greyltc/mechanical/squirrel/notes.txt

needs verification:
1) substarte slot size to remain unchanged from previous versions: 25.354 square
