greyltc/mechanical/chamber_ng/drawings/chamber_plan.dxf

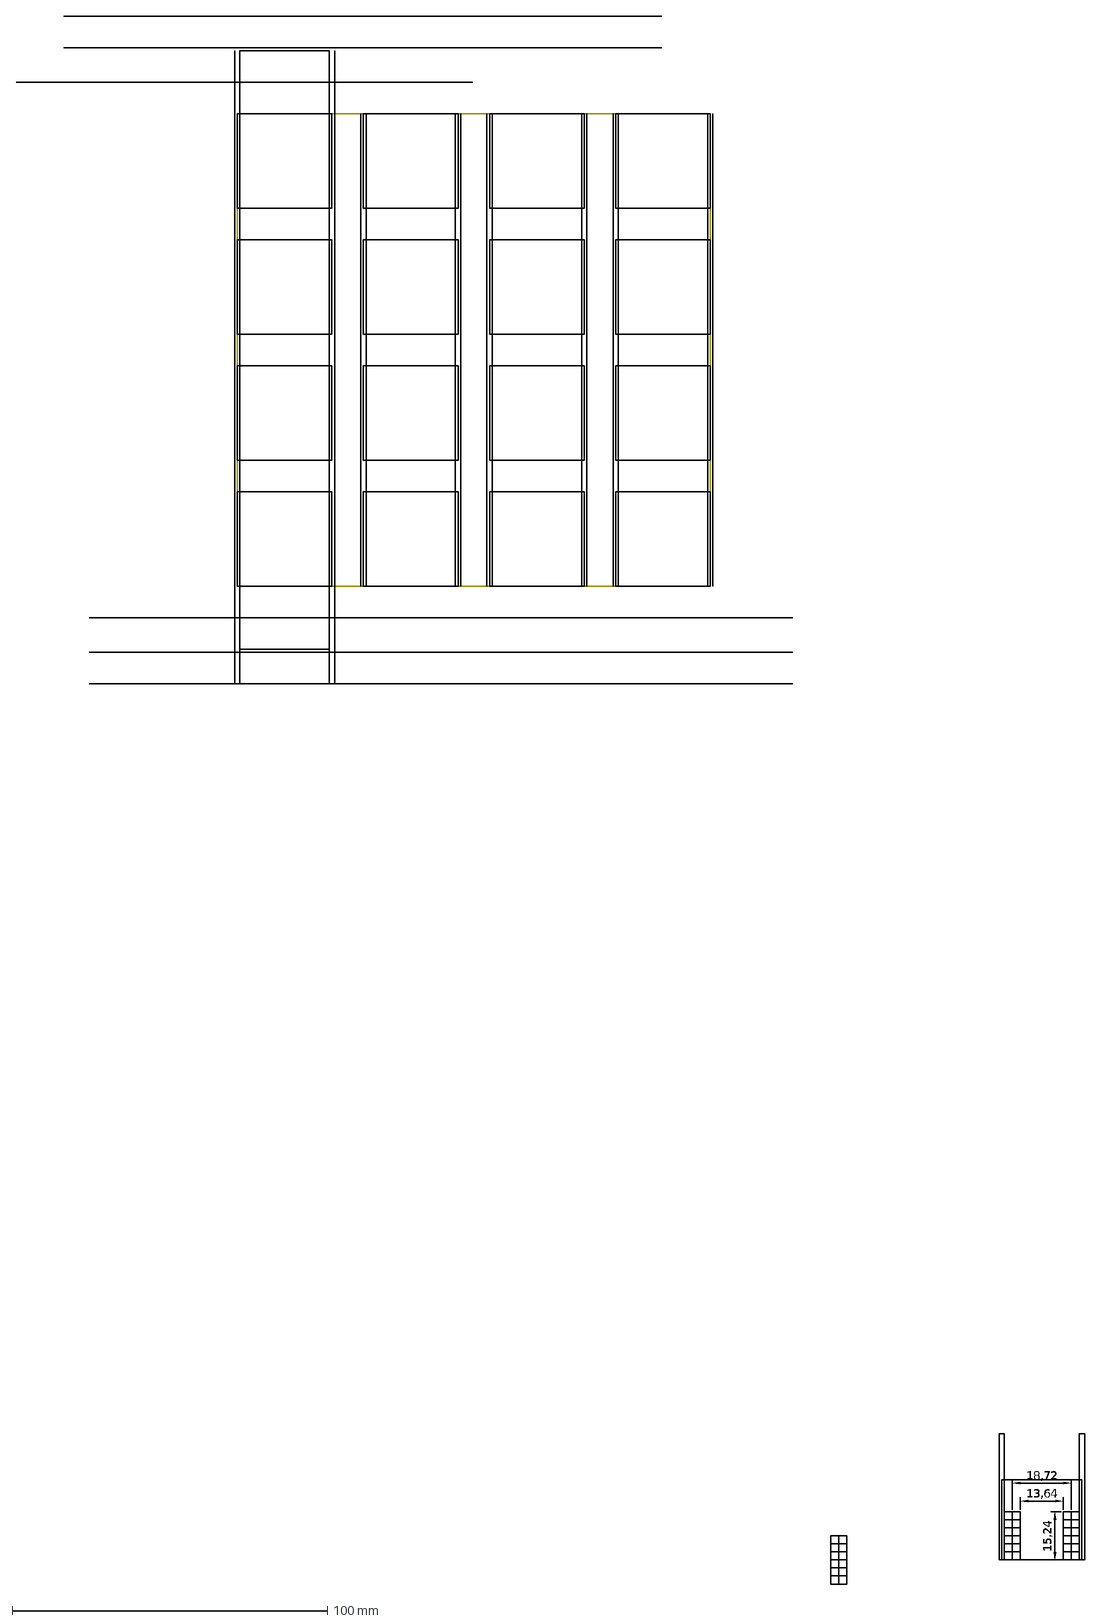
[picture p2: CAD file, 2022-05-18]
chamber_ng/drawings/chamber_plan.dxf
13,64
15,24
18,72
