greyltc/mechanical/component_library/pusherwin_print.step

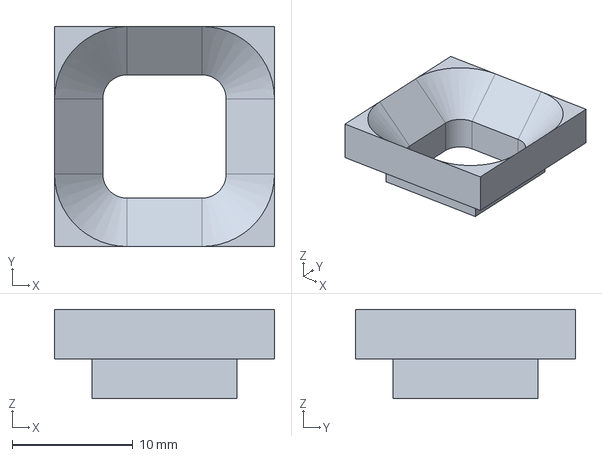
[picture p3: CAD file, 2023-12-13]
component_library/pusherwin_print.step
18.2 x 18.2 x 7.37 mm
