greyltc/mechanical/lightsource/drawings/led_pcb_layout_plan.dxf

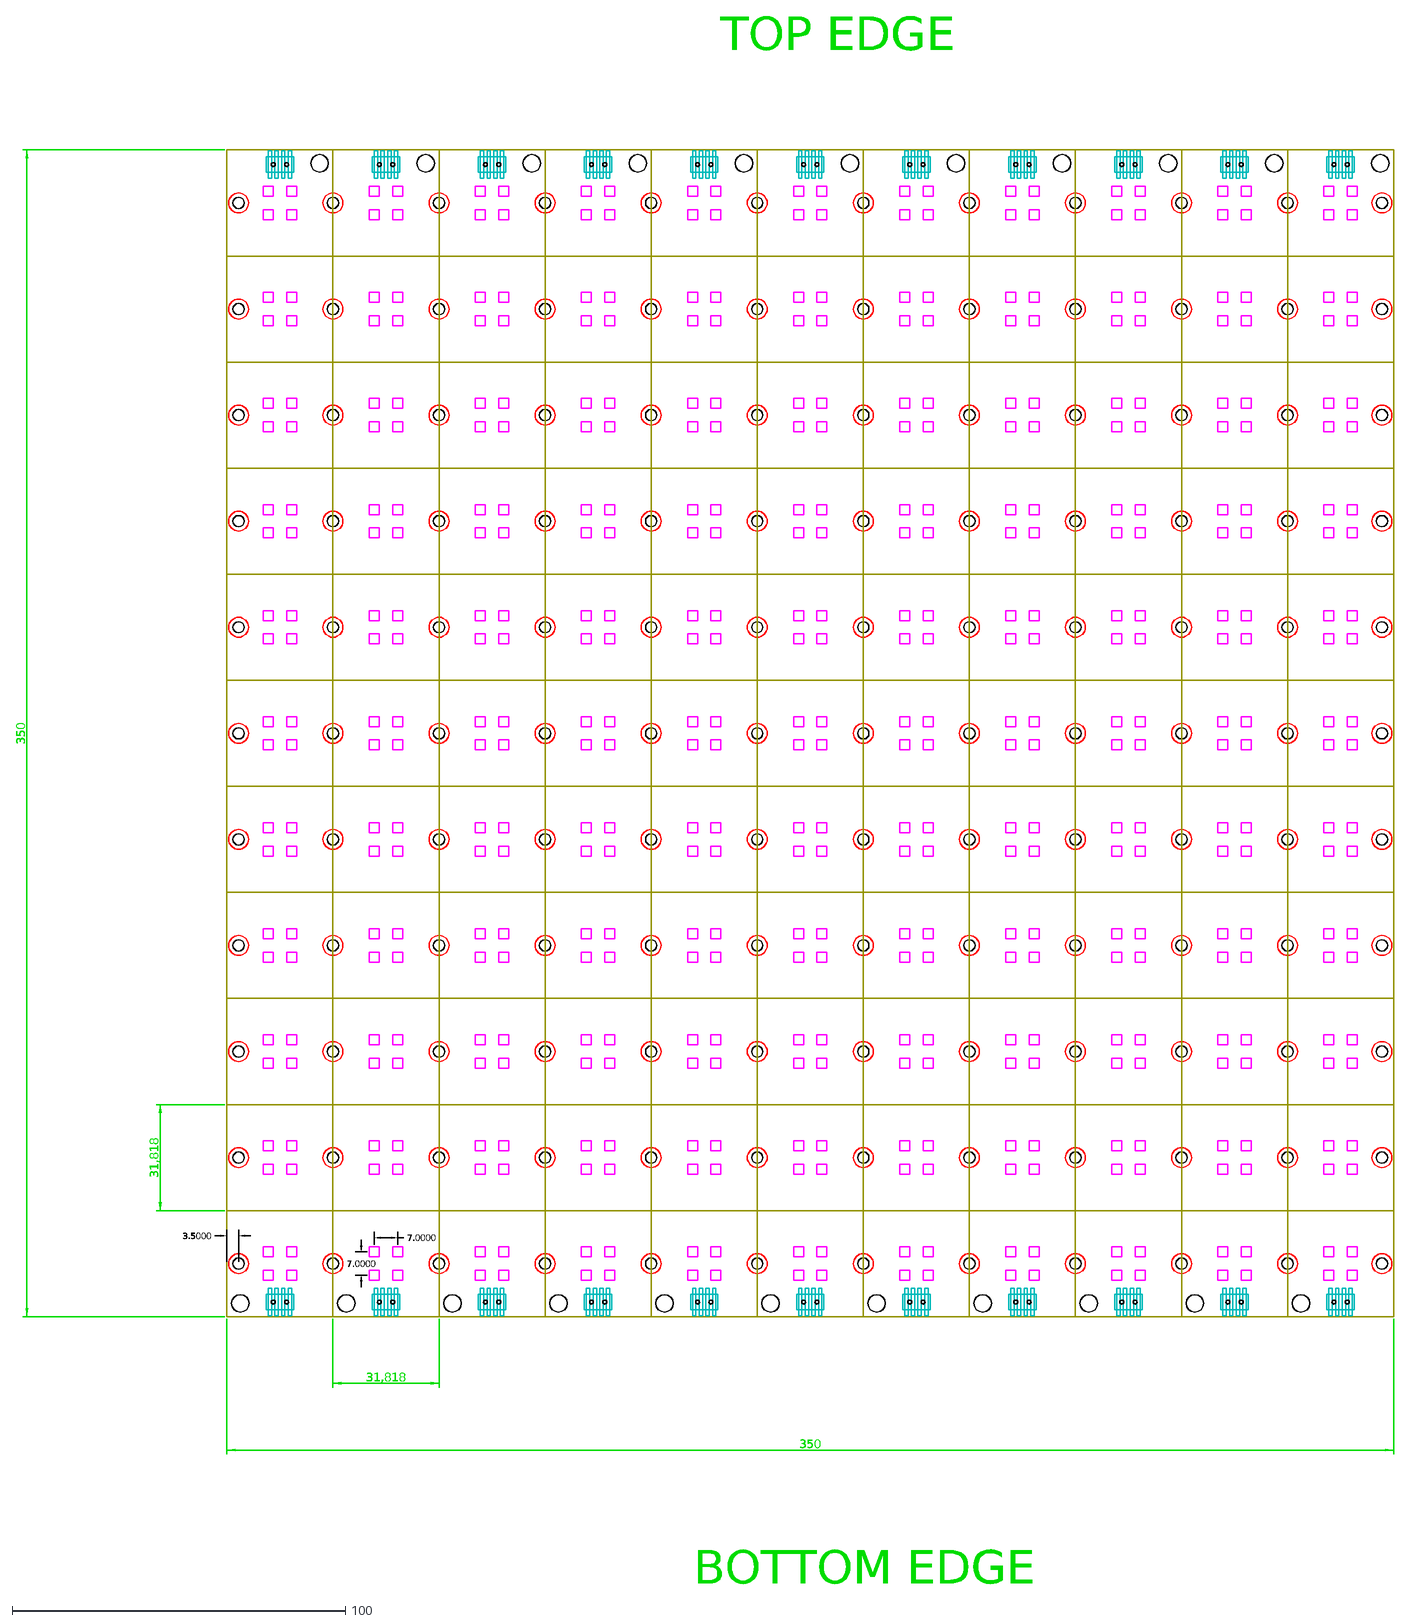
[picture p4: CAD file, 2020-09-10]
lightsource/drawings/led_pcb_layout_plan.dxf
350
31,818
TOP EDGE
BOTTOM EDGE
3.5000
7.0000
