greyltc/mechanical/lim_chamber/drawings/ray_tracing.dxf

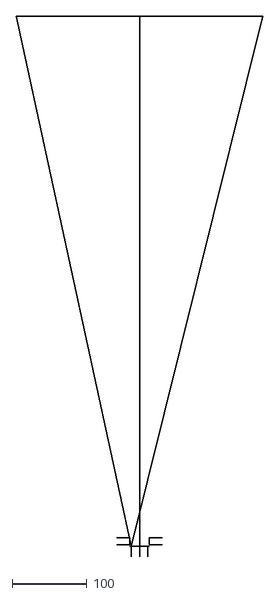
[picture p5: CAD file, 2021-06-05]
lim_chamber/drawings/ray_tracing.dxf
330.0 x 724.1
