greyltc/mechanical/lim_chamber/output/chamber.stp

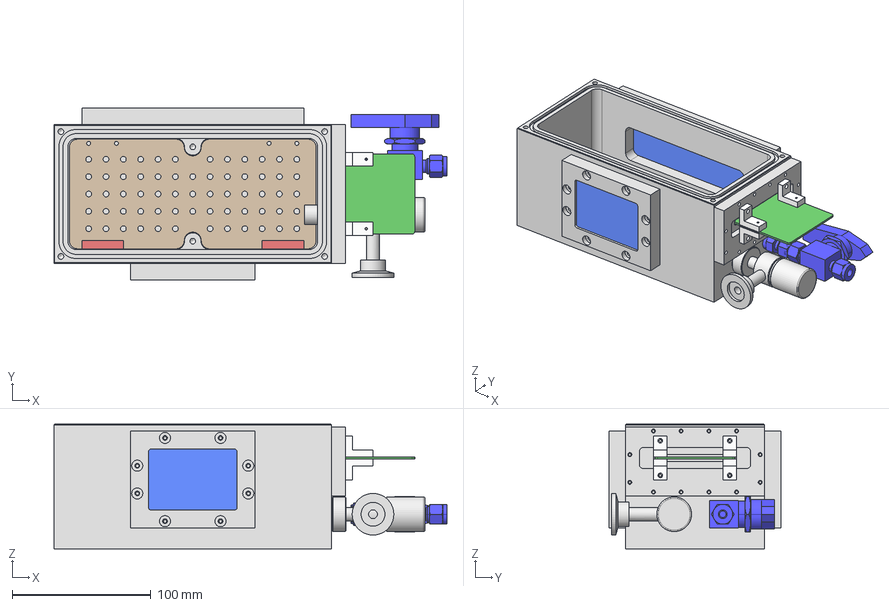
[picture p6: CAD file, 2021-06-05]
lim_chamber/output/chamber.stp
283.2 x 124.0 x 90.0 mm
20180730_boxChamber_jong
20180730_window_2
20180810_onePieceWindowClamp_longWindow
20180730_window_1
20180810_onePieceWindowClamp_longWindow_1
20180807_valveStemColar
vacuumValve
20180807_valveStemCollarOring
SS-6M0-1-M10X10RS_tubeAdapter
SS-401-PC_tubeStub
SS-43GS4_valve
20190820_breadboardInset_1
20191112_circuitBoardMountingPlate x 2
20191126_pcbFeedthrough
20191126_pcb_bracket_threaded x 2
20191126_pcbMockup
20191126_pcb_bracket_threaded_1 x 2
