greyltc/mechanical/otter/components/P1212.060-012.step

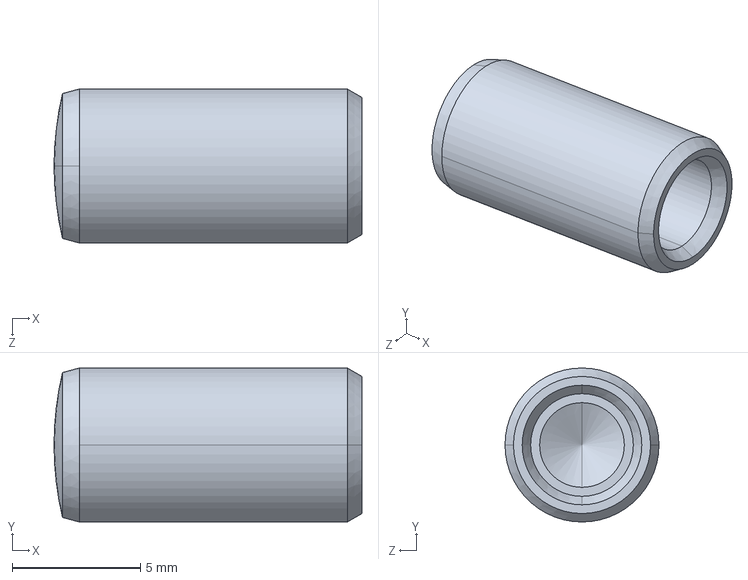
[picture p7: CAD file, 2021-06-05]
otter/components/P1212.060-012.step
12.0 x 6.00 x 6.00 mm
