greyltc/mechanical/rabbit/drawings/2d.dxf

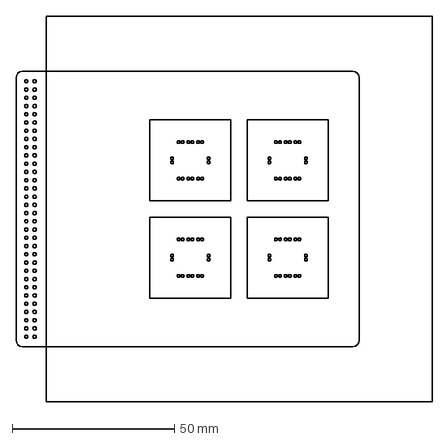
[picture p8: CAD file, 2023-12-15]
rabbit/drawings/2d.dxf
128.3 x 119.0 mm
