greyltc/mechanical/squirrel/drawings/2d.dxf

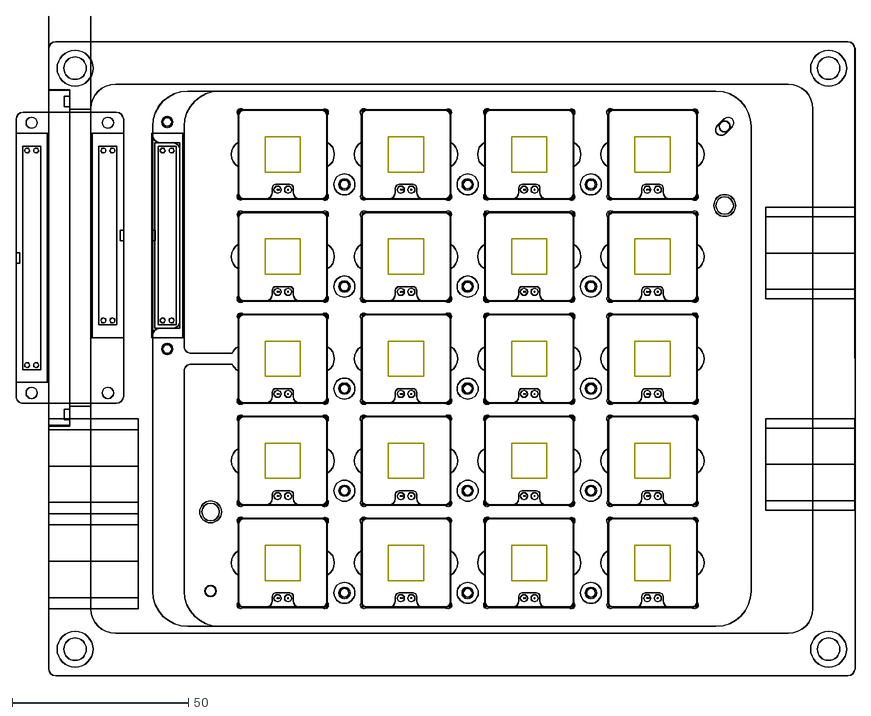
[picture p9: CAD file, 2022-07-04]
squirrel/drawings/2d.dxf
238.3 x 187.2
