greyltc/mechanical/badger/drawings/engineering_sketch.dxf

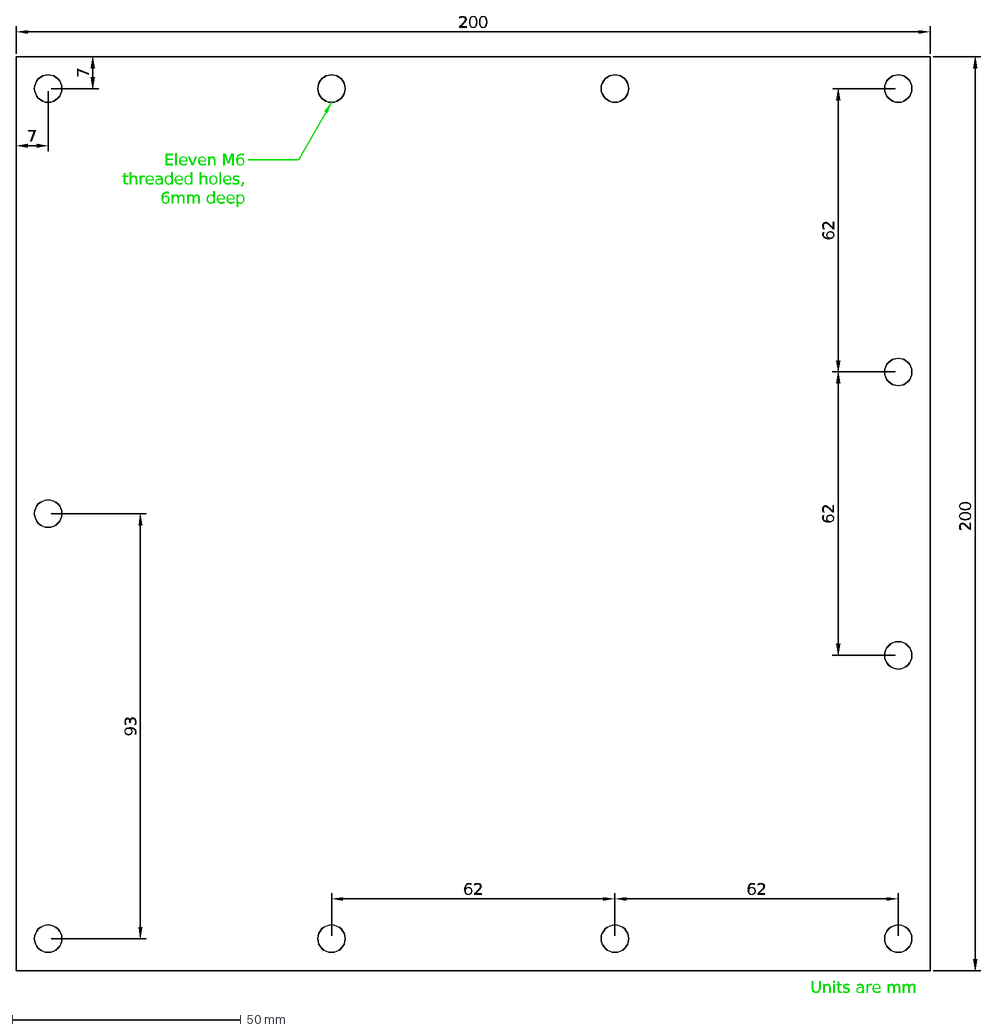
[picture p10: CAD file, 2021-03-10]
badger/drawings/engineering_sketch.dxf
Eleven M6 threaded holes, 6mm deep
200
93
62
7
Units are mm
