greyltc/mechanical/ccbox/components/1455NHD1601.stp

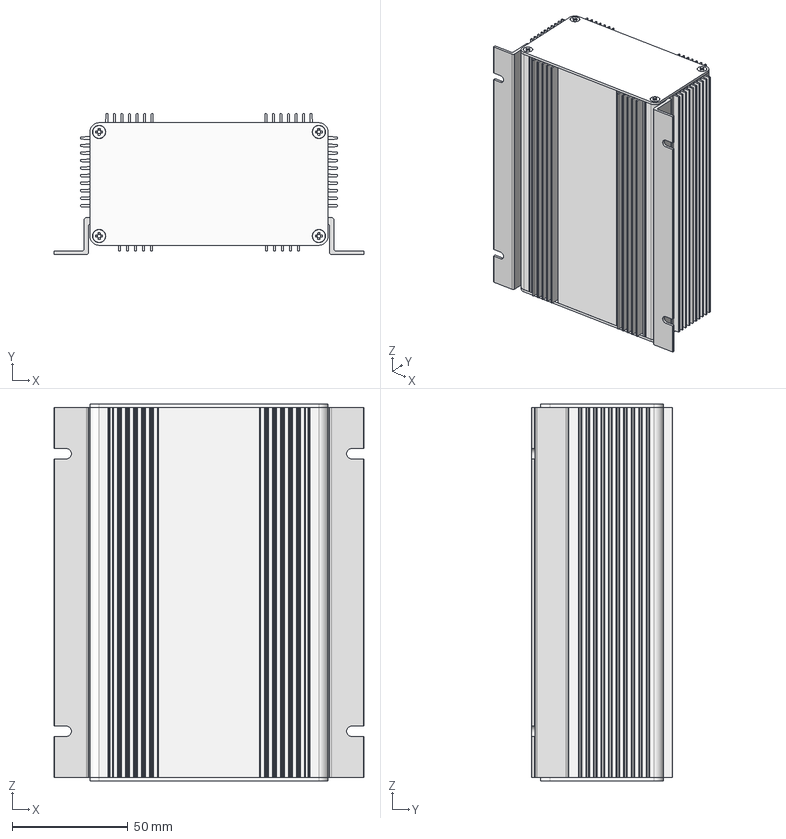
[picture p11: CAD file, 2023-07-14]
ccbox/components/1455NHD1601.stp
134.0 x 61.0 x 163.0 mm
EXT55NHD160
EXT55NBHD160
EXT55NHD160FM x 2
1455N End Plate x 2
1455 screw x 8
