greyltc/mechanical/component_library/cv_print.step

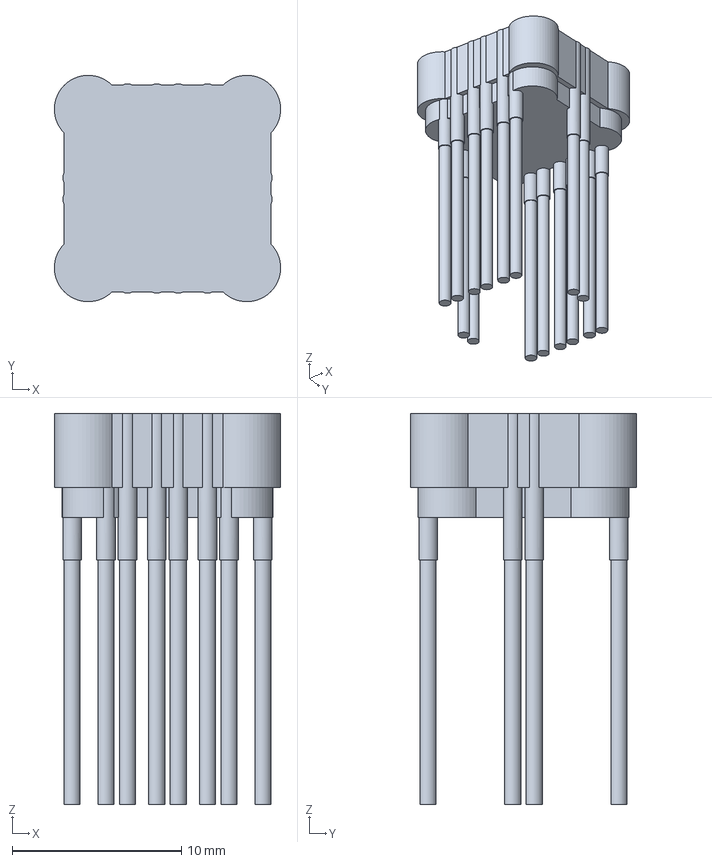
[picture p12: CAD file, 2023-12-13]
component_library/cv_print.step
13.4 x 13.4 x 23.1 mm
