greyltc/mechanical/hoye/drawings/2d.dxf

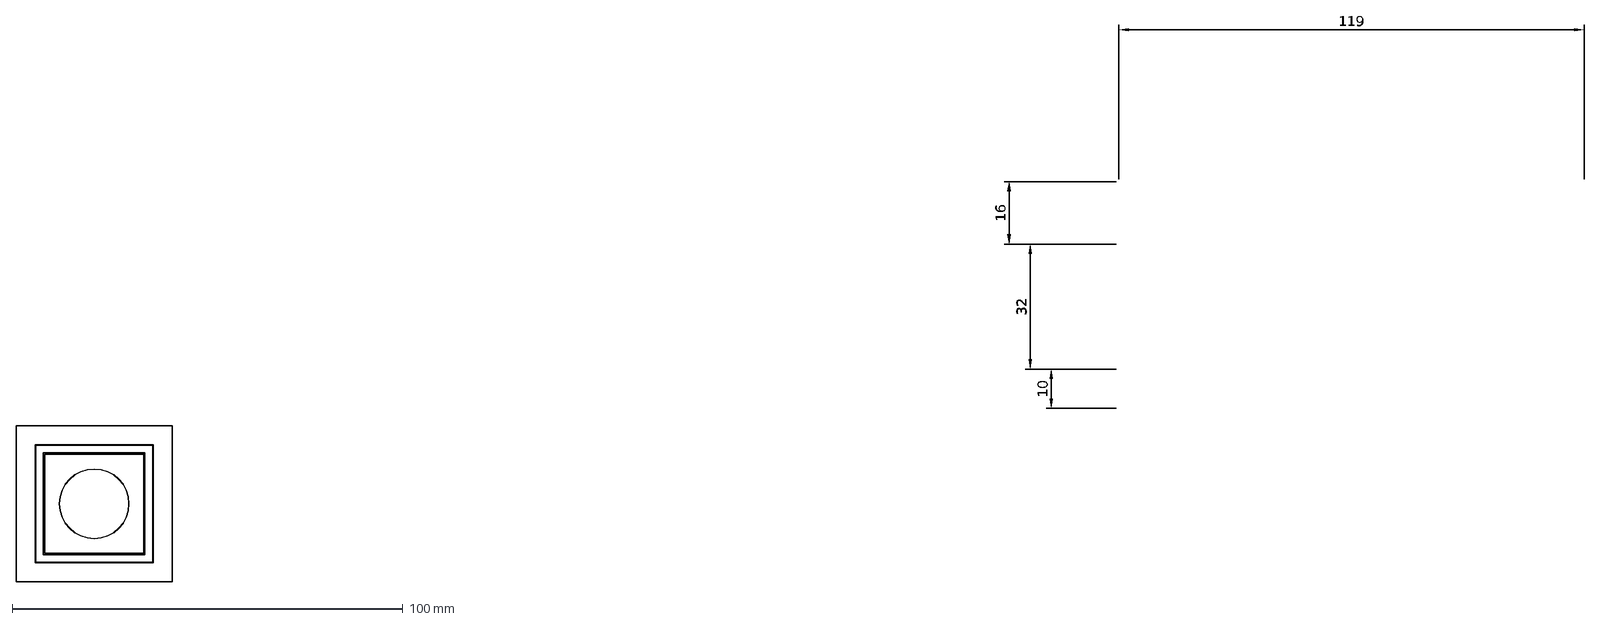
[picture p13: CAD file, 2023-03-22]
hoye/drawings/2d.dxf
119
16
32
10
