greyltc/mechanical/otter/drawings/box_top_cutout.dxf

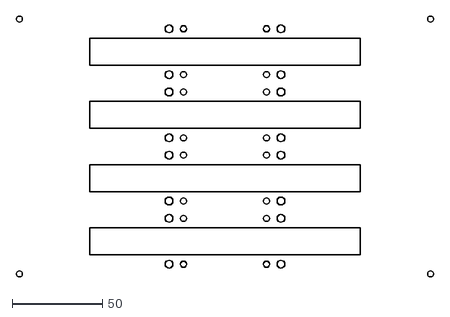
[picture p14: CAD file, 2021-06-05]
otter/drawings/box_top_cutout.dxf
231.3 x 144.6
