greyltc/mechanical/squirrel/components/VHK2-04F-04F.step

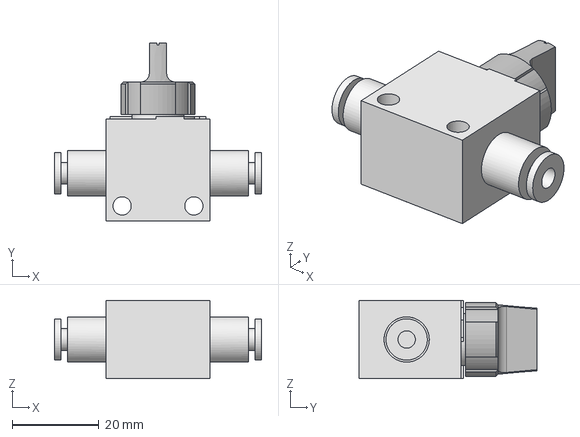
[picture p15: CAD file, 2022-06-06]
squirrel/components/VHK2-04F-04F.step
47.6 x 41.0 x 18.0 mm
_VHK2-04F-04F_BODY
