greyltc/mechanical/component_library/mnt_print.step

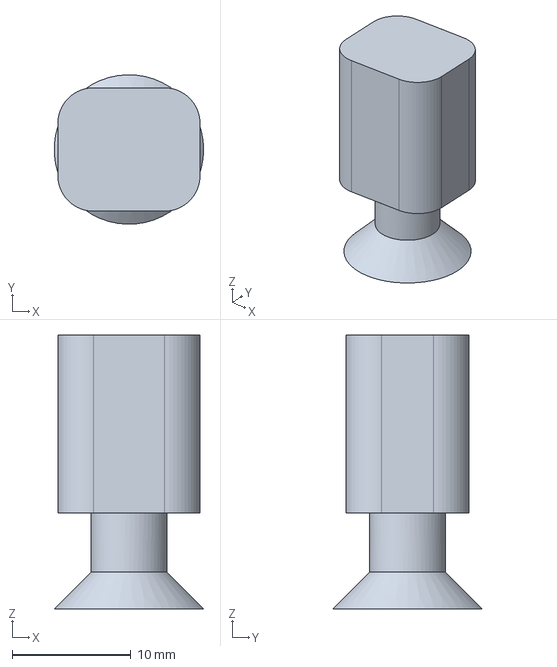
[picture p16: CAD file, 2023-12-13]
component_library/mnt_print.step
12.6 x 12.6 x 23.1 mm
