greyltc/mechanical/squirrel/components/3182_04_00.step

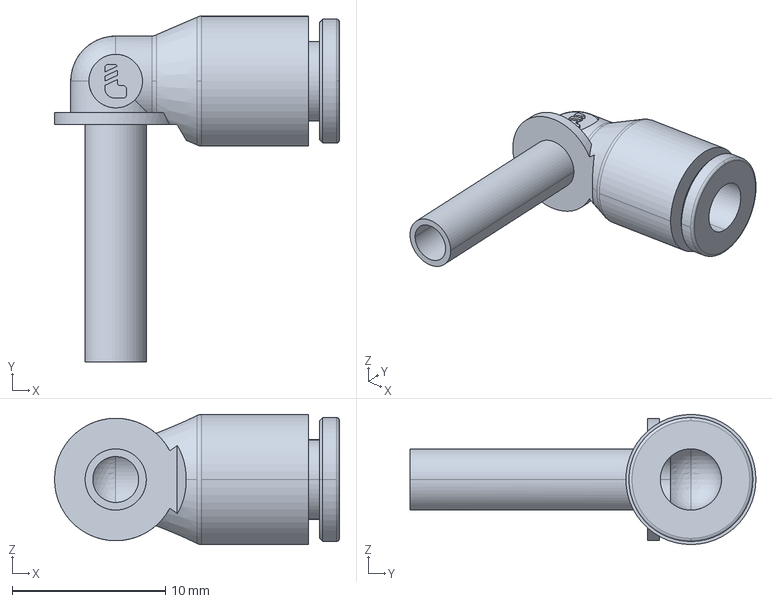
[picture p17: CAD file, 2022-06-06]
squirrel/components/3182_04_00.step
18.6 x 22.6 x 8.50 mm
