greyltc/mechanical/squirrel/drawings/layout.dxf

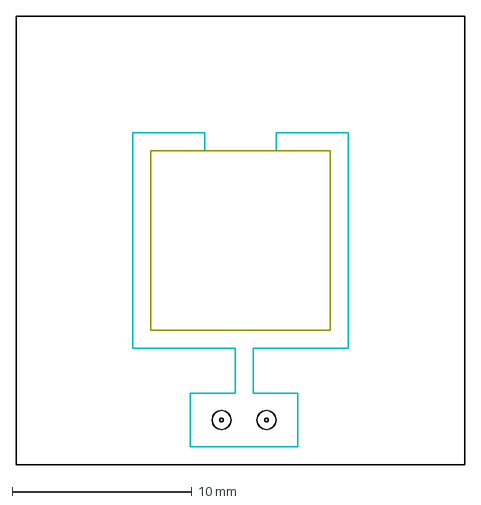
[picture p18: CAD file, 2021-12-14]
squirrel/drawings/layout.dxf
25.0 x 25.0 mm
