greyltc/mechanical/component_library/AKH04B-M5.STEP

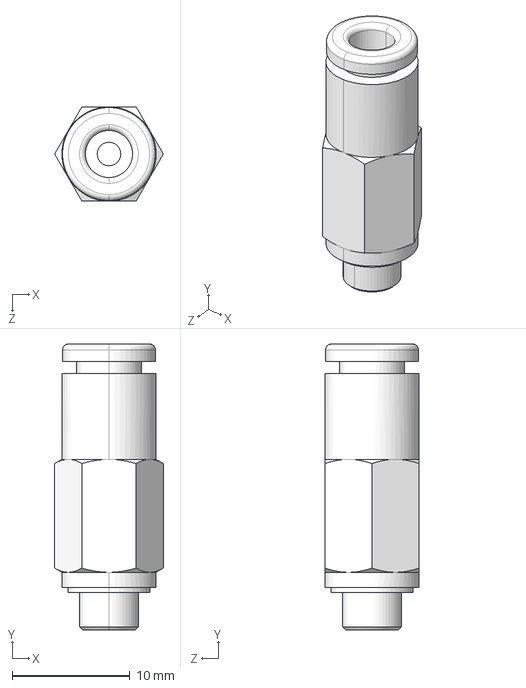
[picture p19: CAD file, 2023-12-13]
component_library/AKH04B-M5.STEP
9.24 x 24.3 x 8.00 mm
