greyltc/mechanical/squirrel/components/hutchinson_ljf_207242.stp

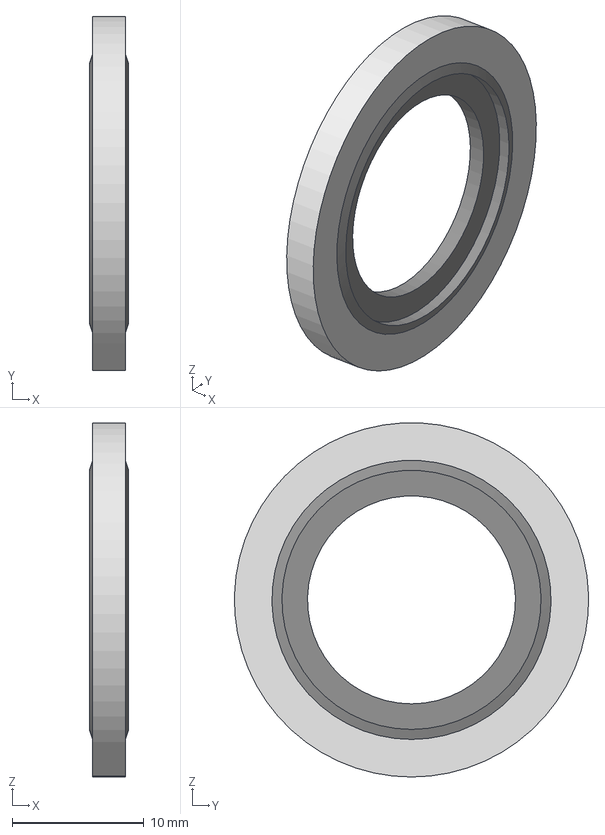
[picture p20: CAD file, 2022-05-16]
squirrel/components/hutchinson_ljf_207242.stp
3.00 x 26.9 x 26.9 mm
