greyltc/mechanical/component_library/SFH213-PPPC-D06-ID-BK+HIF3FB-16DA-2.54DSA(71).step

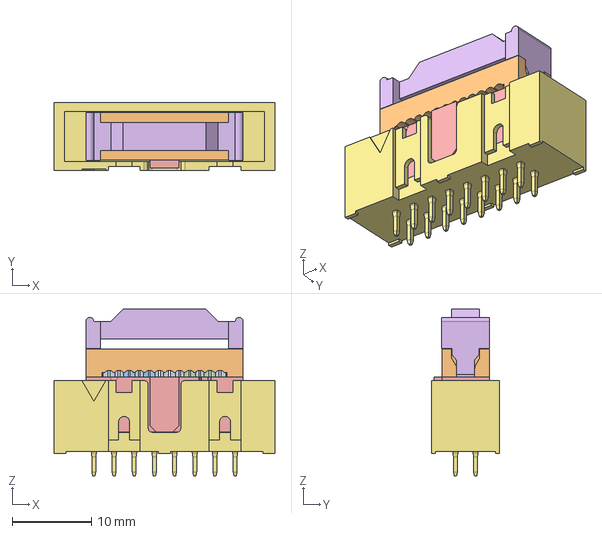
[picture p21: CAD file, 2023-07-13]
component_library/SFH213-PPPC-D06-ID-BK+HIF3FB-16DA-2.54DSA(71).step
27.8 x 8.50 x 21.0 mm
