greyltc/mechanical/squirrel/components/3118_04_19.step

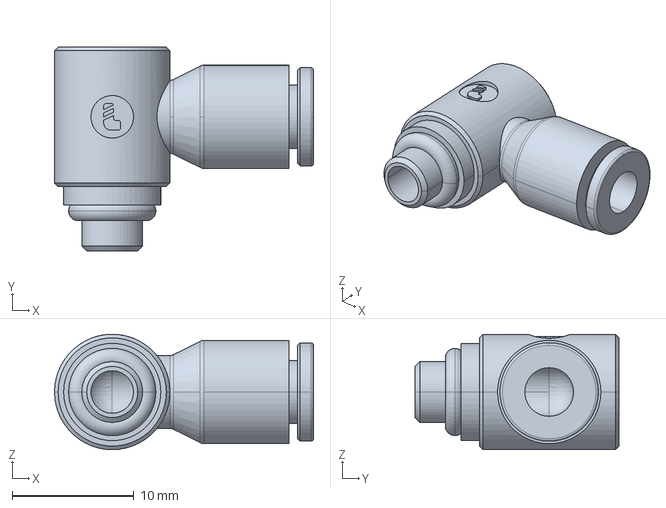
[picture p22: CAD file, 2022-05-12]
squirrel/components/3118_04_19.step
21.3 x 16.8 x 9.50 mm
