greyltc/mechanical/component_library/HIF3FC-16PA-2.54DSA.stp

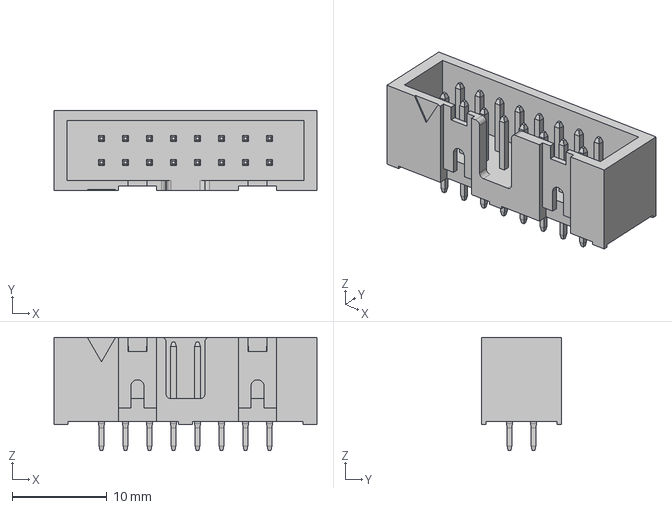
[picture p23: CAD file, 2023-07-13]
component_library/HIF3FC-16PA-2.54DSA.stp
27.8 x 8.50 x 12.0 mm
