greyltc/mechanical/squirrel/components/m-5au-4.stp

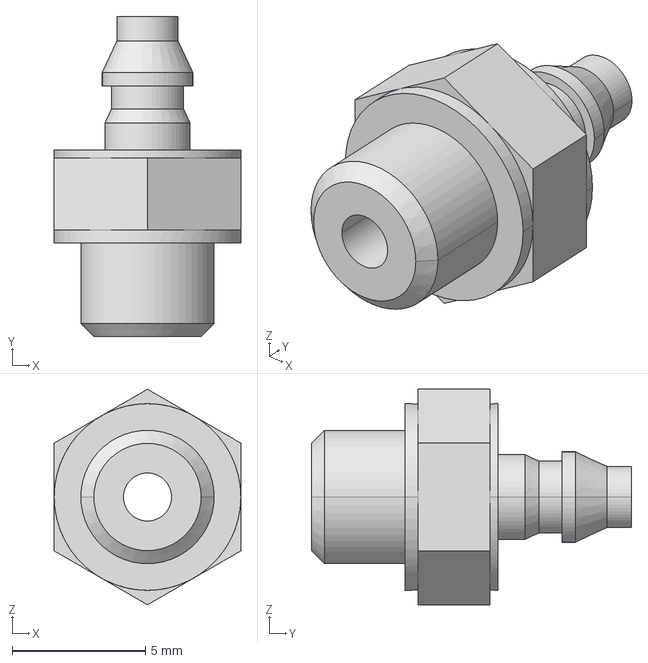
[picture p24: CAD file, 2022-05-05]
squirrel/components/m-5au-4.stp
7.00 x 12.0 x 8.08 mm
