greyltc/mechanical/component_library/TMMH-105-01-T-Q.stp

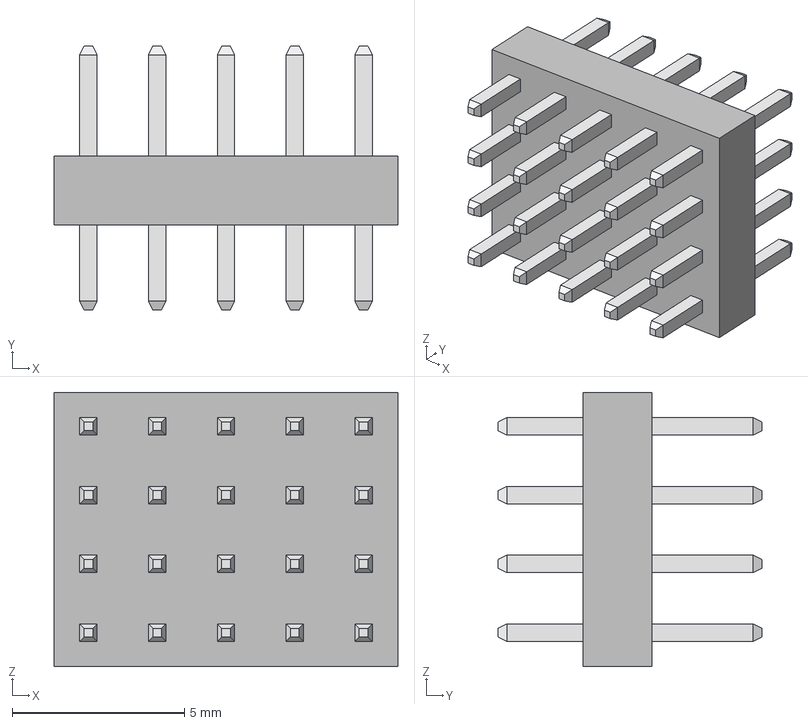
[picture p25: CAD file, 2023-05-08]
component_library/TMMH-105-01-T-Q.stp
10.00 x 7.67 x 7.98 mm
TMMH-105-01-T-Q_pins2
TMMH-105-01-T-Q_pins1
TMMH-105-01-T-Q_body
