greyltc/mechanical/component_library/Download_STEP_970150611 (rev1).stp

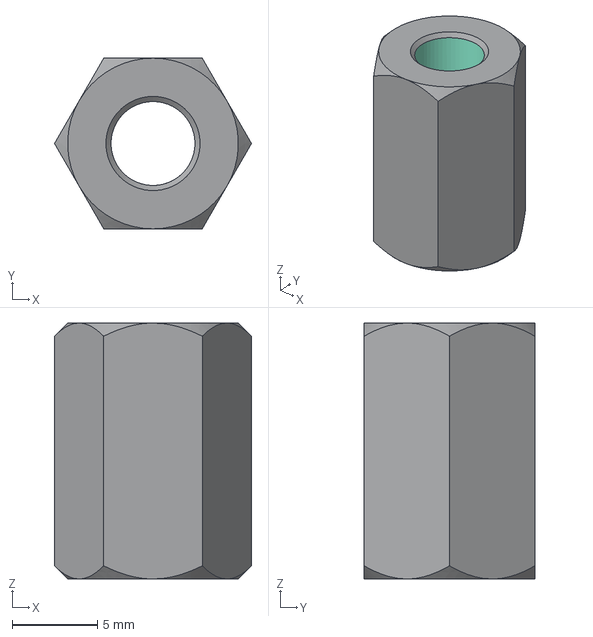
[picture p26: CAD file, 2023-05-07]
component_library/Download_STEP_970150611 (rev1).stp
11.5 x 10.0 x 15.0 mm
