greyltc/mechanical/component_library/P13-4023+S13-503.step

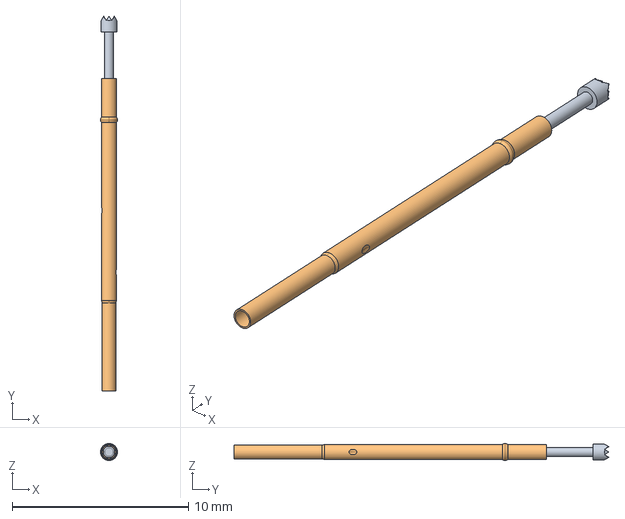
[picture p27: CAD file, 2023-05-07]
component_library/P13-4023+S13-503.step
0.97 x 21.3 x 0.97 mm
