greyltc/mechanical/component_library/Download_STEP_970200611 (rev1).stp

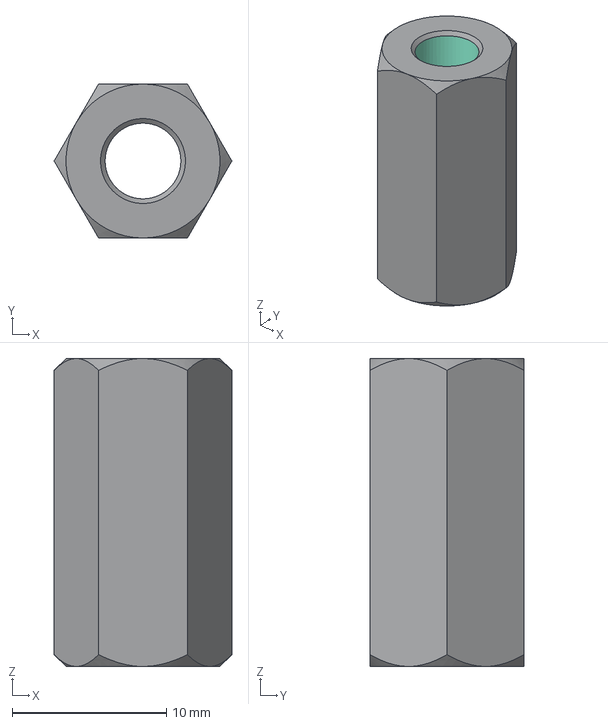
[picture p28: CAD file, 2023-03-23]
component_library/Download_STEP_970200611 (rev1).stp
11.5 x 10.0 x 20.0 mm
