greyltc/mechanical/component_library/S25-022+P25-4023.step

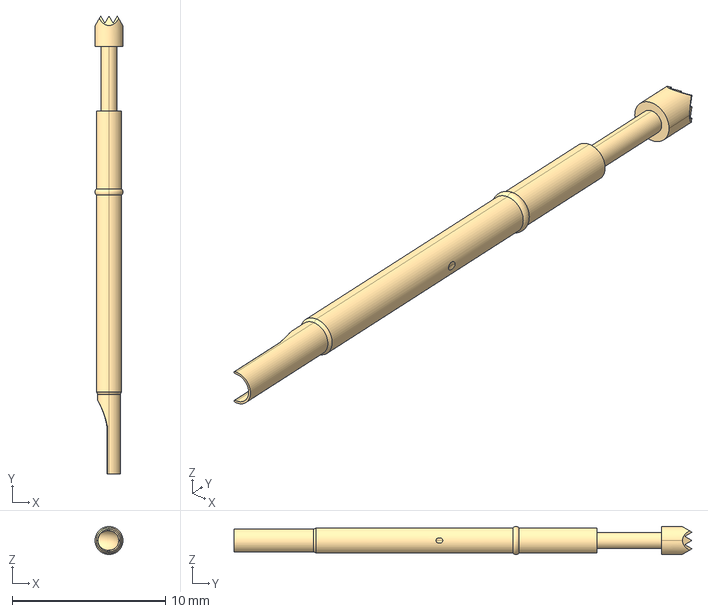
[picture p29: CAD file, 2023-03-22]
component_library/S25-022+P25-4023.step
1.83 x 29.9 x 1.83 mm
