greyltc/mechanical/component_library/SM05F1-Step.step

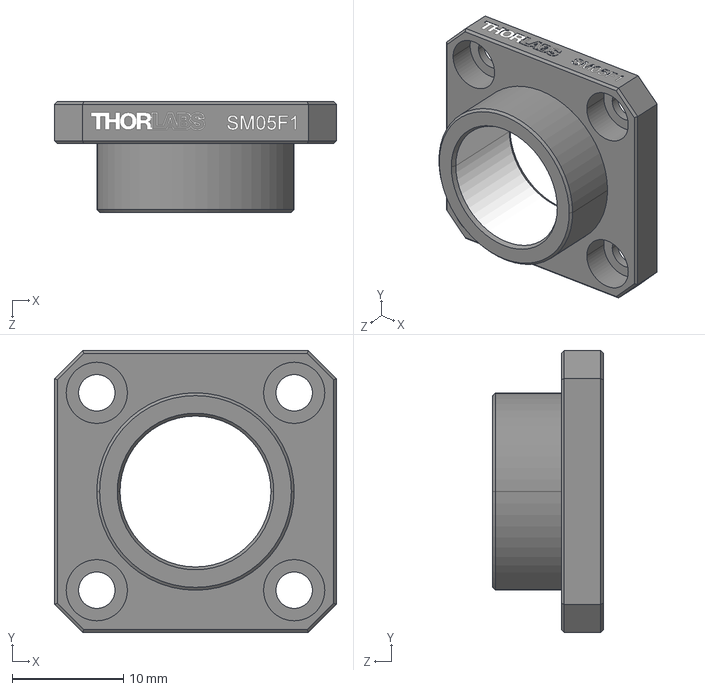
[picture p30: CAD file, 2023-03-22]
component_library/SM05F1-Step.step
25.4 x 25.4 x 10.0 mm
