greyltc/mechanical/component_library/SM05SMA-Step.step

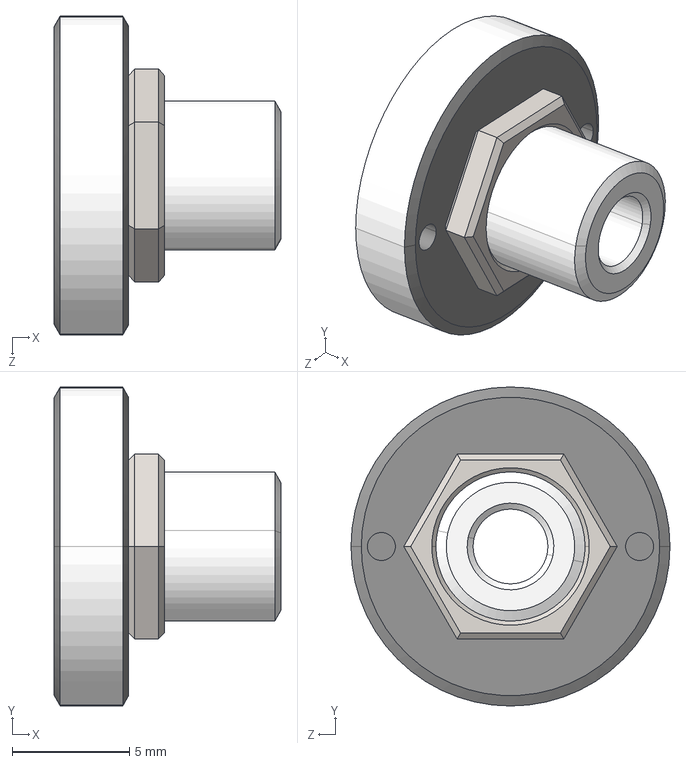
[picture p31: CAD file, 2023-03-22]
component_library/SM05SMA-Step.step
9.65 x 13.6 x 13.6 mm
