greyltc/mechanical/component_library/SM05RR-Step.step

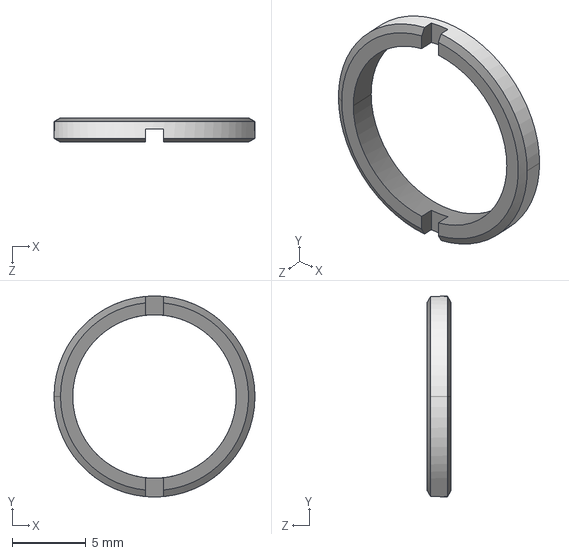
[picture p32: CAD file, 2023-03-22]
component_library/SM05RR-Step.step
13.6 x 13.6 x 1.65 mm
