greyltc/mechanical/(list of files, cad)

Other CAD files:
badger/drawings/2d.dxf
hoye/drawings/acceptance_angle_checking.dxf
otter/drawings/windblocker.dxf
chamber_ng/drawings/ray_tracing.dxf
squirrel/drawings/passthrough.dxf
badger/components/vent_screw.step
component_library/877581017+511101060.stp
hoye/components/010897100.stp
hoye/components/702461602.stp
hoye/components/901301216.stp
squirrel/components/5483T92_Miniature Nickel-Plated Brass Pipe Fitting.STEP
squirrel/components/5483T93_Miniature Nickel-Plated Brass Pipe Fitting.step
