greyltc/mechanical/(threads)

Thread 1 (2021-03-10):

Can this be used to showcase CQ?

adam-urbanczyk, 2021-03-10:
Is this repo at least partially CQ based? Could we use it to advertise CQ somewhere? If so, do you have any recommendations?

greyltc, 2021-03-11:
Hey, sure.
I don't imagine many people would find the stuff here super interesting. It's mostly specialized little widgets. I might use CQ to generate stl files to 3d print the widgets or step files to get them milled out of aluminum.

Unfortunately, much of the code here probably won't run properly if you just clone the repo and try to run the python scripts. Most of the projects load in step files of circuit boards which I design in KiCad (the source for those generally lives in this other repo: https://github.com/greyltc/electronics ) Those PCB step files can get really big so they're not actually checked into git. Most of the stuff here uses a little helper lib, https://github.com/greyltc/mechanical/tree/master/geometrics which gets symlinked into the project folders, I don't know how/if those symlinks work on non-linux platforms.

You can run https://github.com/greyltc/mechanical/blob/master/scratch_tool/build.py and get some simple geometry for a little tool that helps us with one step of our solar cell fabrication process, but maybe that's not the greatest showcase:
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

Running https://github.com/greyltc/mechanical/blob/master/sandwich/build.py makes:
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
which is a four piece holder for helping us make electrical connections to our little research solar cells for characterization.

Running https://github.com/greyltc/mechanical/blob/master/endblock/build.py makes this thing:
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
which is for mounting/aligning some PCBs in a larger assembly.

Running https://github.com/greyltc/mechanical/blob/master/groovy/build.py makes a dovetail o-ring groove (these are good for preventing the o-ring from coming unseated during use):
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

greyltc, 2021-03-29:
okay if I close this?

Closed 2021-03-29.
