greyltc/mechanical/scratch_tool/drawings/bottom_cnc.pdf

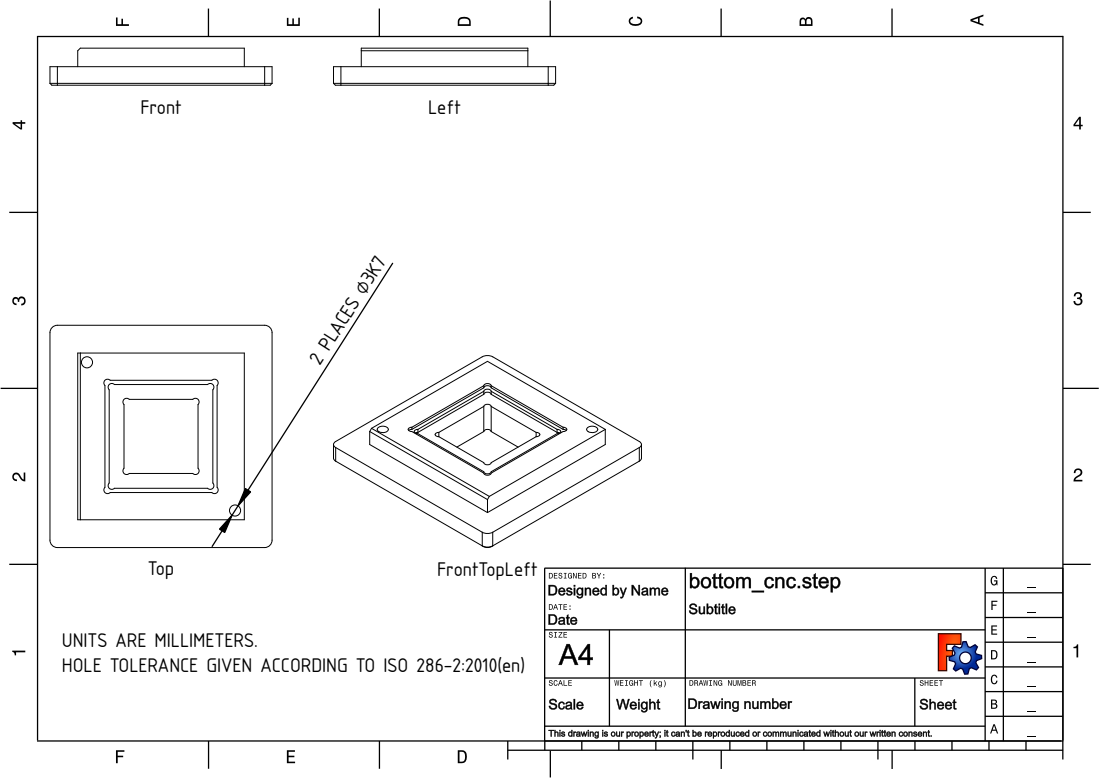
[picture p33: page 1]
Front; Left; Top; FrontTopLeft; PLACES

UNITS ARE MILLIMETERS. HOLE TOLERANCE GIVEN ACCORDING TO ISO 286-2:2010(en)
