greyltc/mechanical/scratch_tool/drawings/top1_cnc.pdf

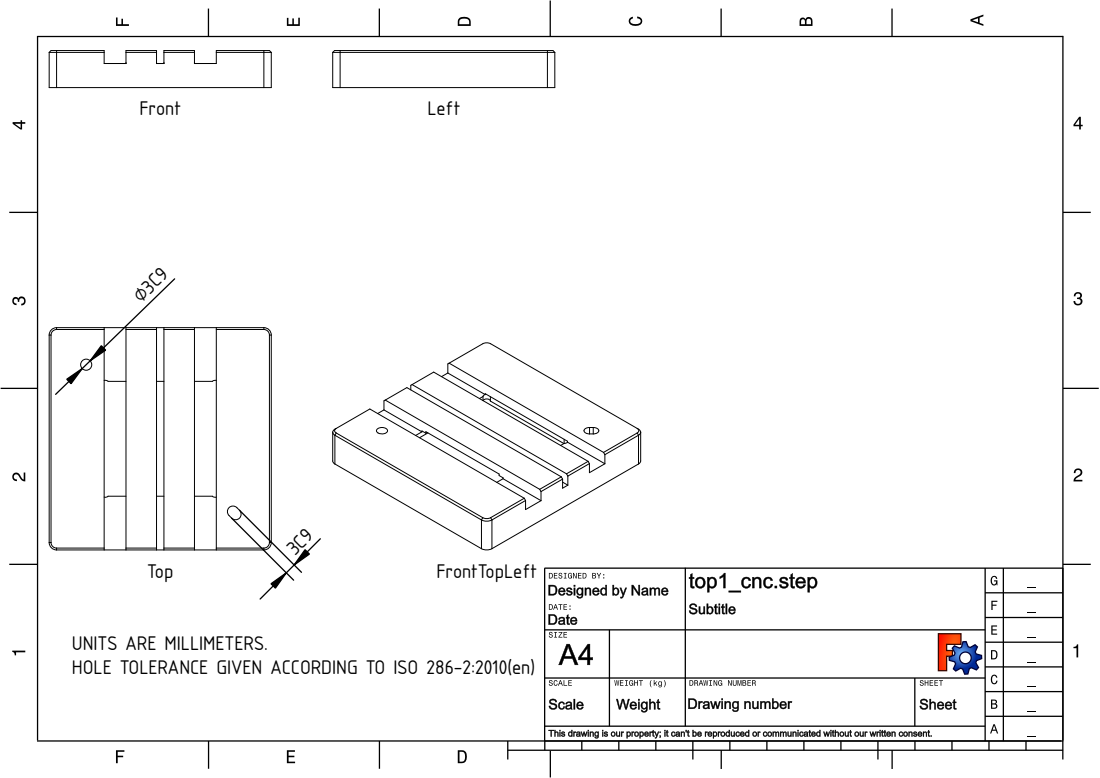
[picture p34: page 1]
Front; Left; Top; FrontTopLeft

UNITS ARE MILLIMETERS. HOLE TOLERANCE GIVEN ACCORDING TO ISO 286-2:2010(en)
