greyltc/mechanical/scratch_tool/drawings/top2_cnc.pdf

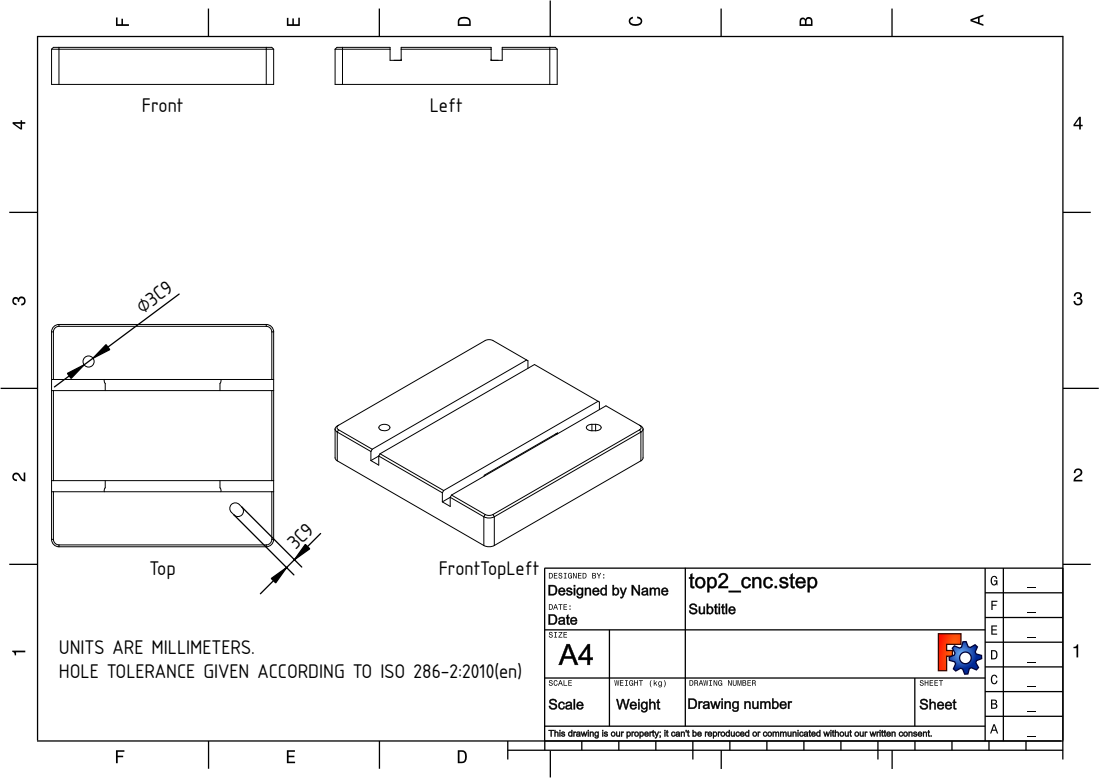
[picture p35: page 1]
Front; Top; FrontTopLeft; Left

UNITS ARE MILLIMETERS. HOLE TOLERANCE GIVEN ACCORDING TO ISO 286-2:2010(en)
