greyltc/mechanical/otter/drawings/endblock_engineering.svg.PDF

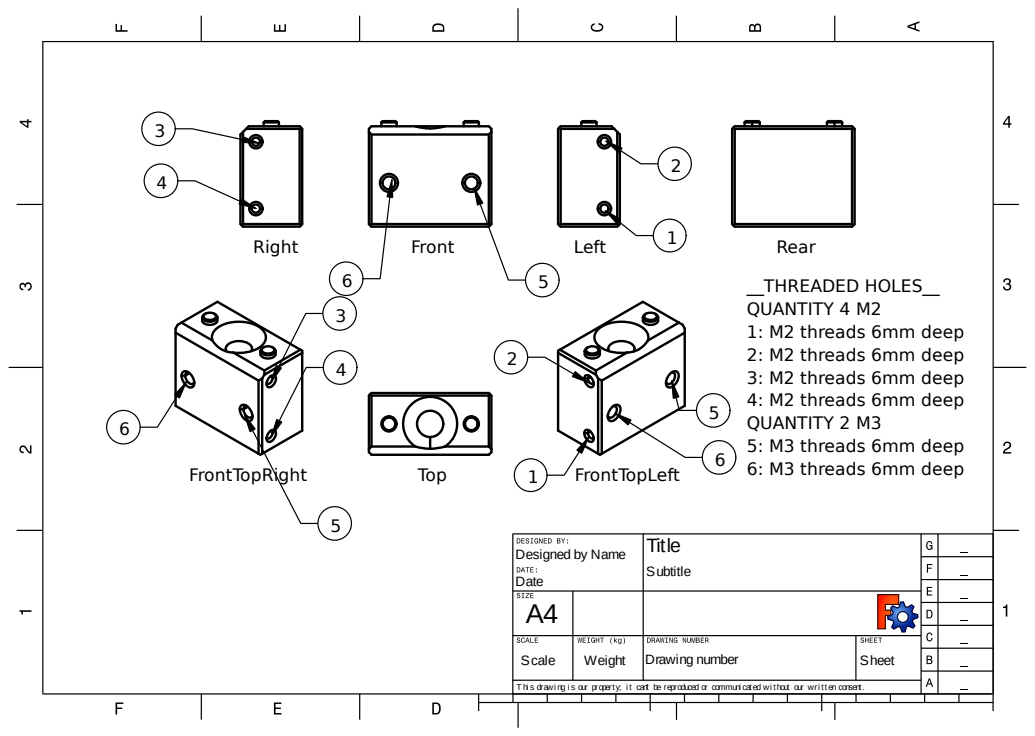
[picture p36: page 1]
Front; Left; Top; FrontTopLeft; Right; FrontTopRight; Rear; __THREADED HOLES__ QUANTITY 4 M2 1: M2 threads 6mm deep 2: M2 threads 6mm deep 3: M2 threads 6mm deep 4: M2 threads 6mm deep QUANTITY 2 M3 5: M3 threads 6mm deep 6: M3 threads 6mm deep

Designed by Name Date | Title Subtitle

Scale | Weight | Drawing number | Sheet

T hi s drawi ng i s our property; i t can't be reproduced or communi cated wi thout our wri tten consent.
