greyltc/mechanical/lim_chamber/drawings/endblock.pdf

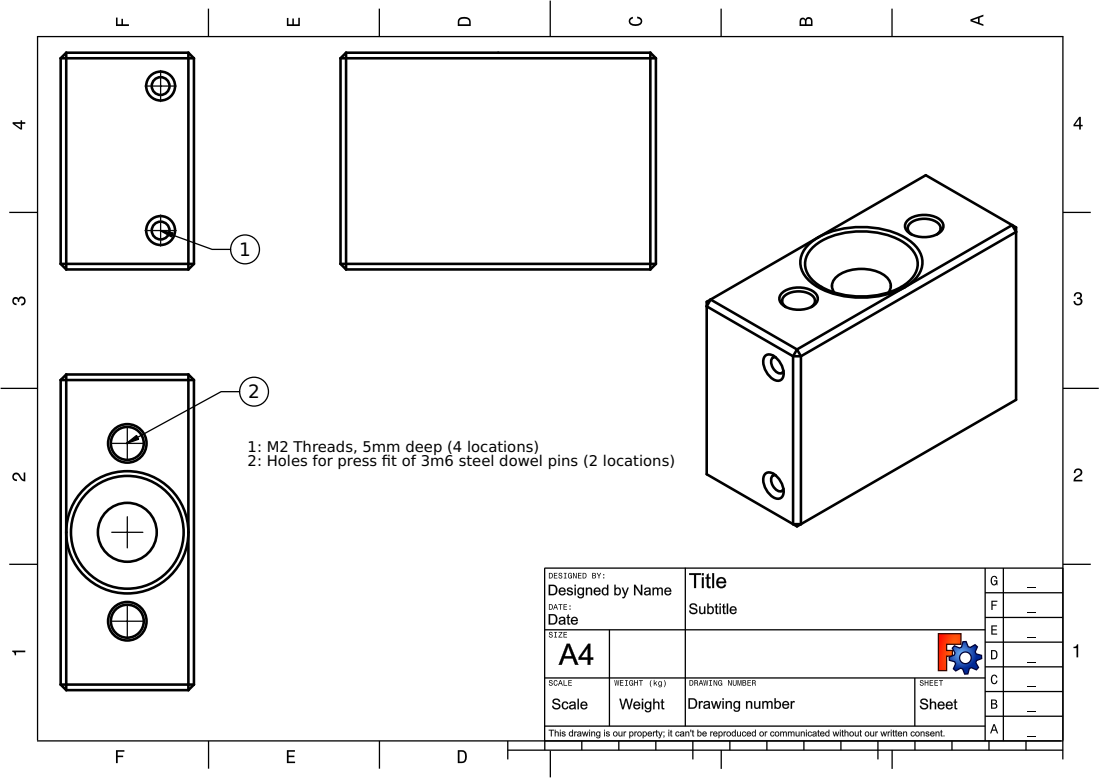
[picture p37: page 1]

1: M2 Threads, 5mm deep (4 locations)
2: Holes for press fit of 3m6 steel dowel pins (2 locations)
