greyltc/mechanical/badger/drawings/engineering_sketch.pdf

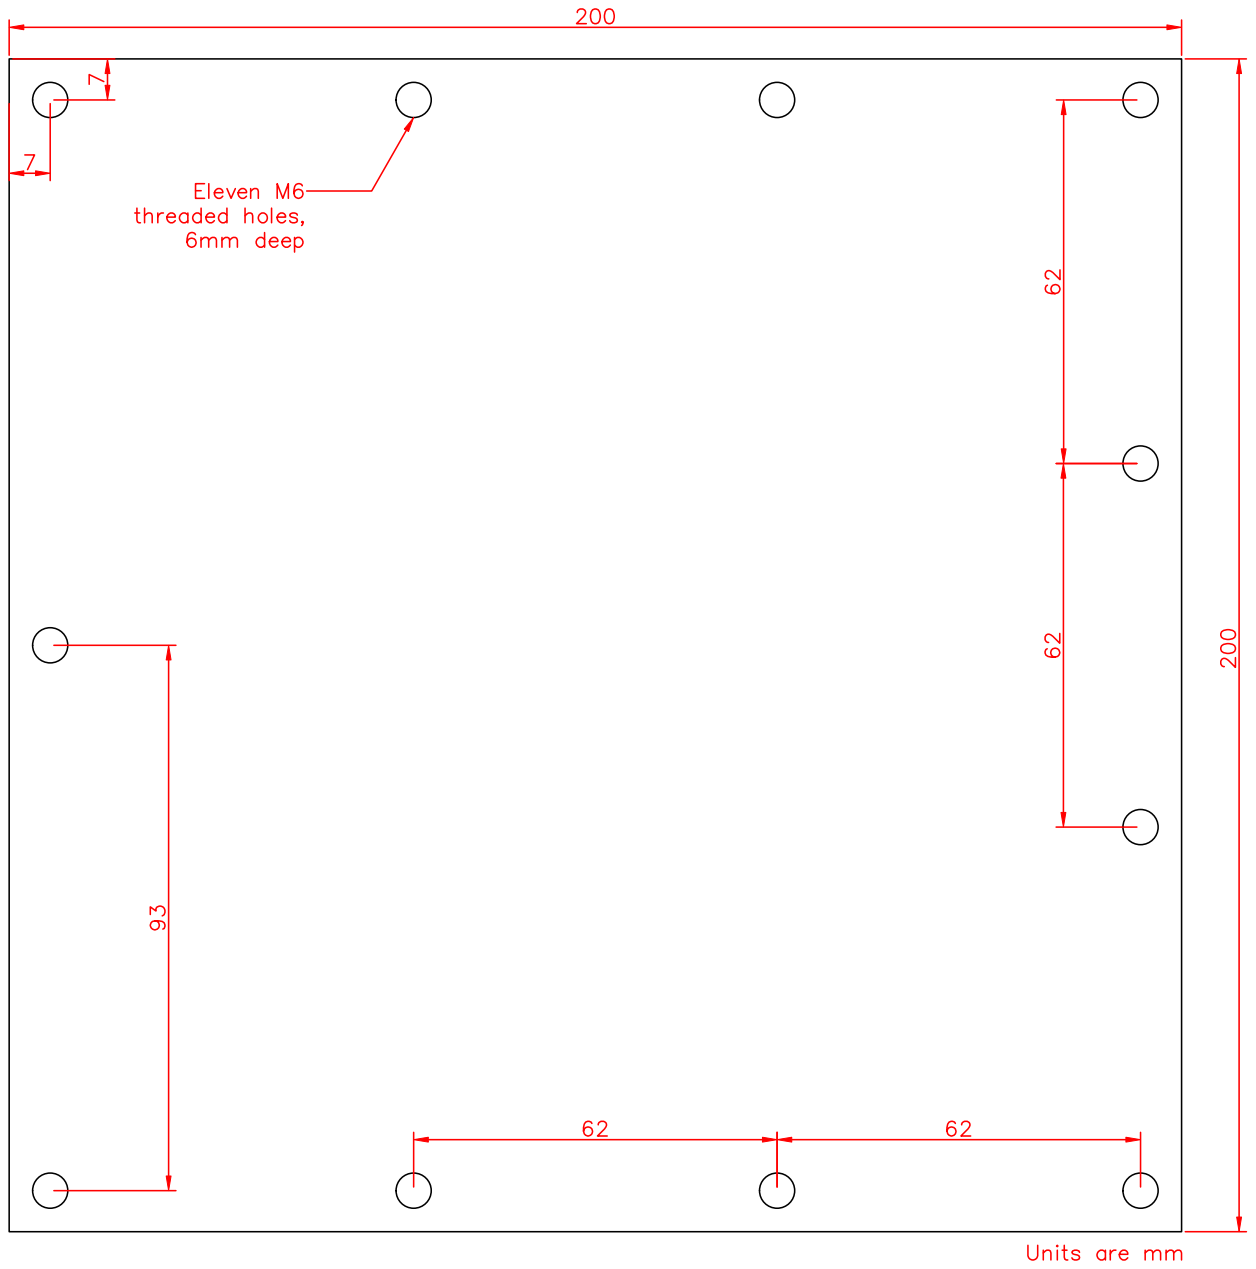
[picture p38: page 1]
