greyltc/mechanical/(commit log)

2019-11-23 wip on PCB passthrough cutout design
    [20190820_boxChamber_jong_rev1.stp, 20190820_breadboardInset_1.stp, 20190820_jongchulVacuumChamber_rev_1_assembly.stp, pcb_passthroughs.scad]
2019-11-24 passthrough scad design done
    [pcb_passthroughs.scad, pcb_passthroughs.step, pcb_passthroughs.stl]
2019-11-24 cleanup polyhedron def
    [pcb_passthroughs.scad]
2019-11-25 start on support plate design, fix up passthrough by breaking out rounded rectangle maker
    [pcb_passthroughs.scad, pcb_support_base.scad]
2019-11-26 fix 0.05mm missing from glue pocket depth, add support for non centered rounted rectangles
    [pcb_passthroughs.scad, pcb_support_base.scad]
2019-11-27 slightly change a few default values to make some numbers rounder
    [pcb_passthroughs.scad]
2019-11-28 add cadquery assembly
    [20190820_boxChamber_jong_rev1.stp, 20190820_breadboardInset_1.stp, 20190820_jongchulVacuumChamber_rev_1_assembly.stp, chamber.stp, pcb_passthroughs.step, pcb_support_base.scad]
2019-12-02 istart building blocks
    [block.step, pcb_passthroughs.step]
2019-12-02 block done
    [block.step]
2019-12-05 re-design PCB mounting blocks
    [L.step, T.step, base.step, block.step, lid.step, my_lid.step, ws.step]
2019-12-27 start on universal path
    [adapterA.step, adapters.step, base.step, block.step, blockm.step, blocks.step, lid.step, pcb_passthroughs.scad]
2019-12-27 fix windows path
    [adapterA.step, base.step, blocks.step, lid.step, ws.step]
2019-12-27 another way to find file
    [adapterA.step, base.step, blocks.step, lid.step, ws.step]
2019-12-28 remove the step files
    [L.step, T.step, adapterA.step, adapters.step, base.step, block.step, blockm.step, blocks.step]
2019-12-28 remove stl and csg files
    [pcb_passthroughs.step, pcb_passthroughs.stl]
2019-12-29 lim chamber assmebly mostly cleaned up
2019-12-29 wip on otter chamber assembly cleanup
2019-12-31 changed tolerance on passthroughs and re-generated steps
    [pcb_passthrough_20.step, pcb_passthrough_8.step, pcb_passthroughs.scad, pcb_passthroughs.step]
2019-12-31 otter chamber assembled
    [pcb_passthrough.scad, pcb_support_base.scad]
2020-01-02 added screw thread dict to constants
2020-01-02 fixed broken change to screw variable dimention
2020-01-03 added std socket screw params, changed std dict names
2020-01-03 added std hex nut parameters
2020-01-03 updated hex nut dimensions
2020-01-03 switch passthrough to cq (WIP)
    [pcb_passthrough.scad]
2020-01-04 addded hex sockets
2020-01-04 added std flanged hex nut params
2020-01-06 endblocks updated, systems integrated, 100% cq generated
    [pcb_passthrough.scad, pcb_passthrough_20.step, pcb_passthrough_8.step]
2020-01-09 add mounting holes to lim chamber
2020-01-09 made variable assignments and function calls consistent with chamber.py
2020-01-22 added std pan head screws
2020-01-27 put some holes in mux lid
2020-01-29 tweak baseboard pcb hole sizes
2020-01-29 add dowel model
    [P1212.060-012.step]
2020-01-29 added std. screw params, changed variable defs to call from chamber
2020-01-29 moved mux box and adapter pcbs up to mount flush with updated base
2020-01-30 made position adjustments to account for pcb lip
2020-02-12 changes to allow for full pin travel
2020-02-13 added stage mounting components
2020-02-13 fix shifted endblock mounting holes
2020-02-13 account for the roundedness of the alignment pin's head
2020-03-10 rev2: 4 alignment posts per substrate, cutouts for tubes in pusher downer, tighter pressfit and looser slidefit and locknut holes
2020-03-15 add some drawings
    [box_top_cutout.dxf, ray_tracing.dxf, windblocker.dxf]
2020-03-15 added the windblocking plates to the master model
2020-03-16 added proper mux box model
    [#box_top_cutout.dxf]
2020-08-23 fix for api change in cylinder
2020-09-10 add update led layout plan
    [chamber_plan.dxf, led_pcb_layout_plan.dxf]
2020-12-18 start work on packaging teh cadquery stuff
    [#led_pcb_layout_plan.dxf]
2021-01-04 scratch tool printed jan 3 2021
2021-01-04 slightly tighter clearance holes
2021-01-18 redo scratch tool with new assembly and constraint system
2021-01-19 wip on ng holder
    [chamber_plan.dxf]
2021-01-30 cut some vgrooves
2021-02-10 no slot round option and initial badger design
    [2d.dxf]
2021-02-11 updates for badger
    [2d.dxf]
2021-02-15 wip on space reservation
    [2d.dxf]
2021-02-20 update badger
    [2d.dxf]
2021-03-10 added crossbar outline generator to ng chamber script
    [engineering_sketch.dxf, ray_tracing.dxf]
2021-03-11 wip on pcb outline generation
2021-03-13 redesign substrate adapter mount
    [ray_tracing.dxf]
2021-03-18 sample holder layer done
2021-03-20 wip on pusher downer
    [ray_tracing.dxf]
2021-03-22 wip on top pcb mounting
2021-03-22 drill edge cutout a bit deeper in aligner
2021-03-22 update some screw constants and badger connector clearance
    [2d.dxf]
2021-03-24 polish and top PCB
2021-04-04 add new build outputs, round pcb corners
2021-04-07 fix potting grove cut
2021-04-16 fix endblock pcb alignment mount (was 0.25mm off)
2021-05-27 update scratcher for cnc, track brep and std files
2021-05-27 add hole notes
2021-06-05 repo reorg
    [#box_top_cutout.dxf, #led_pcb_layout_plan.dxf, 2d.dxf, P1212.060-012.step, box_top_cutout.dxf, chamber.stp, engineering_sketch.dxf, led_pcb_layout_plan.dxf]
2021-06-05 rebuild chamber_ng
2021-06-05 rc2 changes - spring pin spacer redone for encapsulation with individual holes for everything - spring pins moved back by 0.25 each - endblock alignment pin holes deepened - added tweezer access
2021-08-21 space for halfnut, alignment pin width to 13mm, proper hole reporting for spring pin pcb
2021-10-28 start on laser tray
2021-10-28 laser tray v1 done
2021-11-01 update laser tray to be 4mm thick
2021-12-14 add layout
    [layout.dxf]
2022-03-15 fix slot orientation, make mfg dwgs
2022-04-10 some new 2d designs
    [2d.dxf, layout.dxf]
2022-04-11 fix up badger (and don't render ventscrews)
    [2d.dxf, vent_screw.step]
2022-04-11 2d work
    [2d.dxf]
2022-04-23 wip on sq 2d
    [2d.dxf]
2022-04-23 add pcbscrew
    [SHB-M3-5-A2.step]
2022-04-23 add code settings and make 2d-3d converter
    [2d.dxf]
2022-04-23 wip on squ
    [2d.dxf]
2022-04-25 passthrough done
    [2d.dxf, SHB-M3-5-A2.step]
2022-04-25 fix passthrough size
    [2d.dxf]
2022-04-26 hardware in model, base and walls paramatrized
    [2d.dxf]
2022-04-26 move the waterblock mounts
2022-04-26 pedistal and port holes
2022-04-26 remove strange extra holes
2022-04-26 add captive nut pockets with nuts
2022-04-26 no change
    [2d.dxf]
2022-04-26 add component
    [5483T93_Miniature Nickel-Plated Brass Pipe Fitting.step]
2022-04-26 updated countersink screw and o-ring dicts
2022-04-27 use nuts for waterblock mount
2022-05-04 mods to bring assemble_system up to date
2022-05-05 add vac components
    [3527_00_19.stp, 3538_04_19.stp, m-5au-4.stp]
2022-05-05 updated water block hole positions
2022-05-10 fix build in chamber_ng
2022-05-12 improve vac vent hole drilling
2022-05-12 wip on vac chuck
    [3118_04_19.step, 3527_00_19.stp, 3538_04_19.stp]
2022-05-13 tighten up vac screw holes
2022-05-13 bring sample up as far as possible
2022-05-13 fix up lid mounting
2022-05-14 wip on sq pcb
    [2d.dxf]
2022-05-14 update 2d
    [2d.dxf]
2022-05-14 wip on sq pcbs
    [2d.dxf]
2022-05-16 wip on walls upgrades
    [2d.dxf, hutchinson_ljf_207242.stp]
2022-05-18 fixed up some pipe fitting stuff
    [2d.dxf]
2022-05-18 wip on pt
    [2d.dxf, chamber_plan.dxf]
2022-05-24 passthrough wip
    [2d.dxf]
2022-05-24 pt wip
    [2d.dxf]
2022-06-06 add some component cad
    [3182_04_00.step, VHK2-04F-04F.step]
2022-06-07 add the smaller detailed pcb
2022-06-07 fix up big pcb
2022-06-07 fix up small pcb import
2022-06-07 fix small pcb
2022-06-07 adjusted socket clearance to account for change to m5 chamber bolts
2022-07-03 change engineering fit holes in case of mfg fail
    [2d.dxf]
2022-07-03 add option to cut a metric o-ring for the lid
2022-07-04 change window lid screws to match
    [2d.dxf]
2022-07-04 fix thread detection
2022-11-11 specify wheel build
2022-11-21 rabbit mockup
    [2d.dxf]
2022-11-21 add towers
    [2d.dxf]
2022-11-23 wip on rabbit_mockup
    [2d.dxf]
2022-11-25 rabbit mockup improved
    [2d.dxf]
2022-11-26 added pipe fitting
    [5483T92_Miniature Nickel-Plated Brass Pipe Fitting.STEP]
2022-11-26 wip on rabbit mockup
    [2d.dxf]
2022-11-27 generate stls
    [2d.dxf]
2023-01-19 feat(package+edm): mods for edm cad and packaging
2023-02-27 make laser tray stronger
2023-03-22 add some components
    [S25-022+P25-4023.step, SM05F1-Step.step, SM05RR-Step.step, SM05SMA-Step.step]
2023-03-22 add missing drawing
    [2d.dxf]
2023-03-23 wip on 2x1
    [Download_STEP_970200611 (rev1).stp]
2023-03-31 add angle checking
    [acceptance_angle_checking.dxf]
2023-04-20 fix mirrored feature hole shapes
2023-04-25 remove csk screw that can't be mfg'd
    [SHF213+SHB11.step]
2023-05-07 optinal pin cutting
2023-05-07 add 12x12 option to hoye-type holder
    [P13-4023+S13-503.step]
2023-05-07 wip on 2x2
    [2d.dxf, Download_STEP_970150611 (rev1).stp]
2023-05-08 wip on 2
    [877581017+511101060.stp]
2023-06-08 make it easier to switch between hoye&joe
2023-07-13 fix up connectors
    [SFH213-PPPC-D06-ID-BK+HIF3FB-16DA-2.54DSA(71).step, SHF213+SHB11.step]
2023-07-14 contact checker box model set
    [1455NHD1601.stp, 1455NHD1601_plates_removed.stp]
2023-09-13 remove laser label holder
2023-09-13 cut the side nut pocket 2x deep
2023-09-16 make long wall fit on a 58mm pitch
2023-11-06 created more modular lid assembly builder class
2023-11-07 automatically calculate number of support bolts and their positions based on minimum spacing
2023-11-07 added ability to choose between recessed nut and countersink screw for fastening lid to chamber; tidied up some general calculations for screws
2023-12-13 rabbit first deraft done
    [2d.dxf, AKH04B-M5.STEP]
2023-12-13 add some rabbit components
    [cv_print.step, mnt_print.step, pusher_win.step]
2023-12-14 wip on rabbit chamber
2023-12-15 new component lib rabbit finishing touches
    [2d.dxf, 877581017+511101060.stp, AKH04B-M5.STEP, Download_STEP_970150611 (rev1).stp, Download_STEP_970200611 (rev1).stp, HIF3FC-16PA-2.54DSA.stp, P13-4023+S13-503.step, S25-022+P25-4023.step]
2023-12-15 added support for removing corner bolts that fasten the window support to the lid
2023-12-15 removed corner bolts on window support
2023-12-15 rename folder
    [2d.dxf, AKH04B-M5.STEP, cv_print.step, mnt_print.step]
2024-03-27 improve way to pick face for dxf export calc cut lengths and extents for easier quotes
2024-04-08 side nut pocket depth fix
2024-10-22 completely disable multiprocessing if the user asks for only one thread (solves a debugging issue)
2024-10-22 no longer discard all but one solid for single drawing layer layers (except for 2d case)
2024-12-16 add rabbit drawings
    [2d.dxf]
2025-04-11 add small hoye
    [010897100.stp]
2025-04-11 upgrades for hoye12
    [702461602.stp, 901301216.stp]
