greyltc/mechanical/(notices)

Notices in the files:
squirrel/components/VHK2-04F-04F.step:
FILE_NAME( 'e:/temp/worker_361/temp/exporttempdir_5700_47_rClri/format_0/VHK2-04F-04F.stp', '2022-05-26T09:15:24', ( 'License CC BY-ND 4.0' ), ( 'CADENAS' ), ' ', 'PARTsolutions', ' ' );
squirrel/components/hutchinson_ljf_207242.stp:
FILE_NAME( 'p:/temp/worker_208/temp/exporttempdir_4444_1106_wfs3W/format_0/hutchinson_ljf_207242.stp', '2022-05-16T21:08:37', ( 'License CC BY-ND 4.0' ), ( 'CADENAS' ), ' ', 'PARTsolutions', ' ' );
component_library/TMMH-105-01-T-Q.stp:
author */ ('License CC BY-ND 4.0'),
